NegativCut/XY_AUDIO_PLOTTER/STM_MCP6022_AFE.pdf

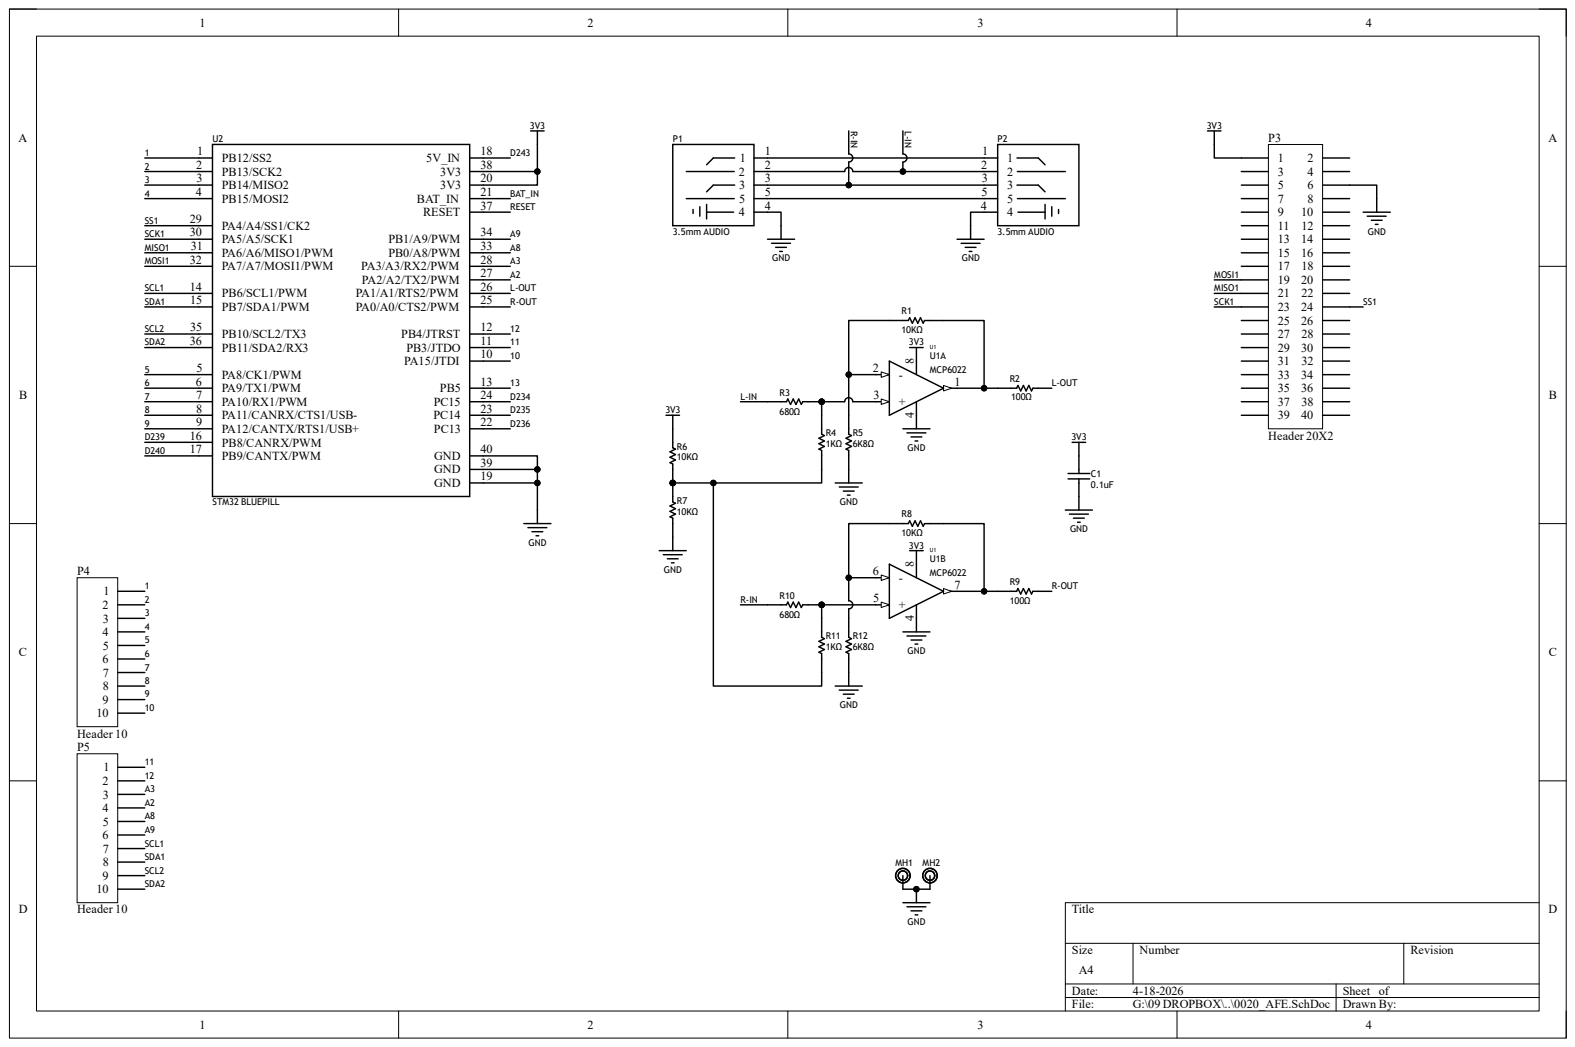
[picture p1: page 1]
