NegativCut/XY_AUDIO_PLOTTER/SIMULATION/XY-AFE.asc

C1: cap; 0.1
R1: res; 10k
R2: res; 10k
R3: res; 10k
R4: res; 6k8
R5: res; 100
R6: res; 680
R7: res; 1k
U1: OP191
U2: OP191
V1: voltage; 3.3
V2: voltage; SINE(0 1.05 20000)
Named nets: 0, v, vout, vin
.tran 0.002s
6k8 and 10k for 1v pk-pk to 1.65v pk-pk
R4 and R2
whats the max vout from pc line-out?
