NegativCut/XY_AUDIO_PLOTTER/PI_SETUP/config.txt

# Display config - 1024x768 monitor
disable_overscan=1
hdmi_force_hotplug=1
hdmi_group=2
hdmi_mode=17

# Enable SPI
dtparam=spi=on

# Enable audio
dtparam=audio=on

# WiFi country code
country=TH

[all]
