NegativCut/XY_AUDIO_PLOTTER/(commit log)

2026-04-04 Initial commit: project spec and Pi Zero config
    Add XY Audio Plotter project spec (MD) and Pi Zero config.txt
    for Raspberry Pi OS Bookworm Lite 32-bit (1024x768, SPI enabled, TH WiFi region).
    [config.txt]
2026-04-04 Update build log and add STM32 SPI slave test sketch
    Document April 2026 build progress: Pi Zero (no WiFi), Blue Pill mounted,
    Arduino IDE + STM32duino 2.12.0 configured. Add SPI slave loopback sketch
    using direct register setup.
2026-04-06 Add Pi setup scripts, visualiser, and config files
    - visualiser.py: direct framebuffer Lissajous renderer, 32-bit ARGB8888, 24 FPS with glow
    - setup.sh: automated Pi setup script (filesystem expand, apt, groups, config, udev, visualiser)
    - config.txt: HDMI 1024x768, SPI, ENC28J60 overlay
    - 70-enc28j60-mac.rules: fixed MAC address for ENC28J60
    - XY-Audio-Plotter.md: build log updated with Pi Zero and Pi 3B setup progress
    [config.txt]
2026-04-06 Update visualiser and TODO list
    - visualiser.py: upsampled np.interp line drawing attempt (backup preserved)
    - XY-Audio-Plotter.md: comprehensive TODO list added covering rendering, SPI, analog front-end, and polish
2026-04-07 Vectorised line interpolation and rendering cleanup
    - visualiser.py: fixed-step vectorised interpolation (8 steps/segment), no Python loops
    - Removed unused glow constants and offset lists
    - XY-Audio-Plotter.md: updated build log and TODO list
    [visualiser.py]
2026-04-07 Adopt Cairo renderer, add CRT effects demo
    - visualiser.py: rewritten using pycairo — anti-aliased lines, 24 FPS
    - demo.py: rewritten using pycairo — focus (line width) + persistence (alpha fade)
    - setup.sh: added python3-cairo to dependencies
    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
2026-04-08 Pivot to Pi 3B: update front-end spec, add STM32 dummy SPI sketch
    - Remove ENC28J60 overlay, udev MAC rule (Pi 3B has built-in ethernet)
    - Free CE0 for Blue Pill; update all references CE1→CE0
    - Update setup.sh: Cairo visualiser in heredoc, add python3-spidev
    - Add STM_FIRMWARE/spi_xy_dummy: animated Lissajous over SPI slave DMA
    - Add PI_SETUP/spi_xy_read.py: reads 4096-byte XY buffer from CE0
    - Correct analog front-end gain 4.19x→1.68x (Rf=6.8k, Rg=10k) for 3.3V supply
    - Update spec doc: Pi 3B throughout, corrected component values, build log
    [config.txt]
2026-04-08 Add SPI CE0 link test sketches for Pi and Blue Pill
    Blue Pill sends fixed 16-byte pattern over SPI1 slave.
    Pi reads and validates — confirms full SPI link before moving to XY data.
2026-04-08 Update build log: static IP, SPI link test transfer, memory updated
2026-04-10 SPI link proven; visualiser reading live STM32 dummy XY data at 24 FPS
    - spi_loopback_ce0 v0.1.0: DMA TX+RX slave — 10/10 pass at 16 MHz
    - spi_xy_dummy v0.0.2: LUT-based Lissajous, DMA TX+RX, versioned
    - spi_xy_read.py: added __main__ test block (24-frame default)
    - visualiser.py: replaced internal Lissajous with spi_xy_read SPI input
    - cam_fb0.py: Pi Camera v1.3 framebuffer preview (picamera2, RGB correct)
    [cam_fb0.py, visualiser.py]
2026-04-10 Consolidate to single production app; add real ADC firmware
    Pi: inline SPI into visualiser.py, remove all test/demo/backup scripts.
    STM32: add spi_xy_adc v1.0.0 (dual regular ADC, TIM3 96kS/s, DMA),
    remove spi_xy_dummy and spi_loopback_ce0. Update build log and TODO.
2026-04-18 Add MCP6022 AFE schematic; update build log and TODO
    - Add STM_MCP6022_AFE.pdf: dual-channel MCP6022 front-end schematic
    - Document PCB routing decisions (PA0/PA1 swap, no input coupling caps for initial test)
    - Confirm R4/R11 role as bias feed resistors; gain unchanged at 1.68x
    - Update TODO: schematic done, next is bench signal verification
2026-04-18 Add LTspice AFE simulation; update build log with gain analysis
    - Add XY-AFE.asc/.net/.raw: single-channel MCP6022 AFE simulation (OP191 model)
    - Bias buffer (U2 unity-gain follower) confirmed as design improvement over passive divider
    - Net gain ~1.47x: op-amp 2.47x attenuated by R6/R7 input divider (0.595x)
    - DC output 1.65V, no clipping at 1.05V peak worst-case input — simulation verified
2026-04-18 Reduce buffer to 512 pairs to cut pipeline latency
    Halves audio accumulation time (10.67ms -> 5.33ms) and SPI transfer
    time. Reverts unused mapping change. Firmware bumped to v1.1.0.
    [spi_xy_adc.ino, visualiser.py]
2026-04-18 Add velocity-based colour mapping to Lissajous trace
    Segments coloured by velocity: blue (slow/bass) -> green (mids) ->
    white (fast/highs). 16 colour bands drawn as batched Cairo paths
    (16 stroke calls per frame vs 511).
2026-04-18 Improve colour spread: wider ramp + sqrt velocity curve
    Blue->cyan->green->yellow->white ramp across 5 stops. Square-root
    velocity normalisation spreads low-velocity segments across more bands.
2026-04-18 Test colour pipeline: colour by segment index not velocity
2026-04-18 Add dark red background to confirm correct file is running
    [visualiser.py]
2026-04-18 Restore velocity-based colour mapping, black background
2026-04-19 Bump SPI clock to 20 MHz
    Within STM32F103 slave limit (18 MHz rated, tested at <5cm).
2026-04-20 Add phosphor persistence effect
    Semi-transparent black overlay fades previous frames. PERSISTENCE
    constant controls decay rate (0.15 = ~1s trail at 24 FPS).
2026-04-20 Switch to warm colour palette: deep red -> orange -> amber -> warm white
2026-04-20 Add auto-scaling with exponential smoothing
    Scales and centres the Lissajous figure to fill 90% of the screen
    based on the signal's actual range. Smooth tracking avoids jumpy
    scaling on transients.
    [visualiser.py]
2026-04-20 Fix auto-scale: snap to peaks instantly, decay slowly
    Scale jumps immediately to accommodate loud transients, then
    gradually relaxes. Prevents clipping without chasing every peak.
    [visualiser.py]
